Shrutik-KaPatel/SpinDoctor/Docs/Images/1I.png

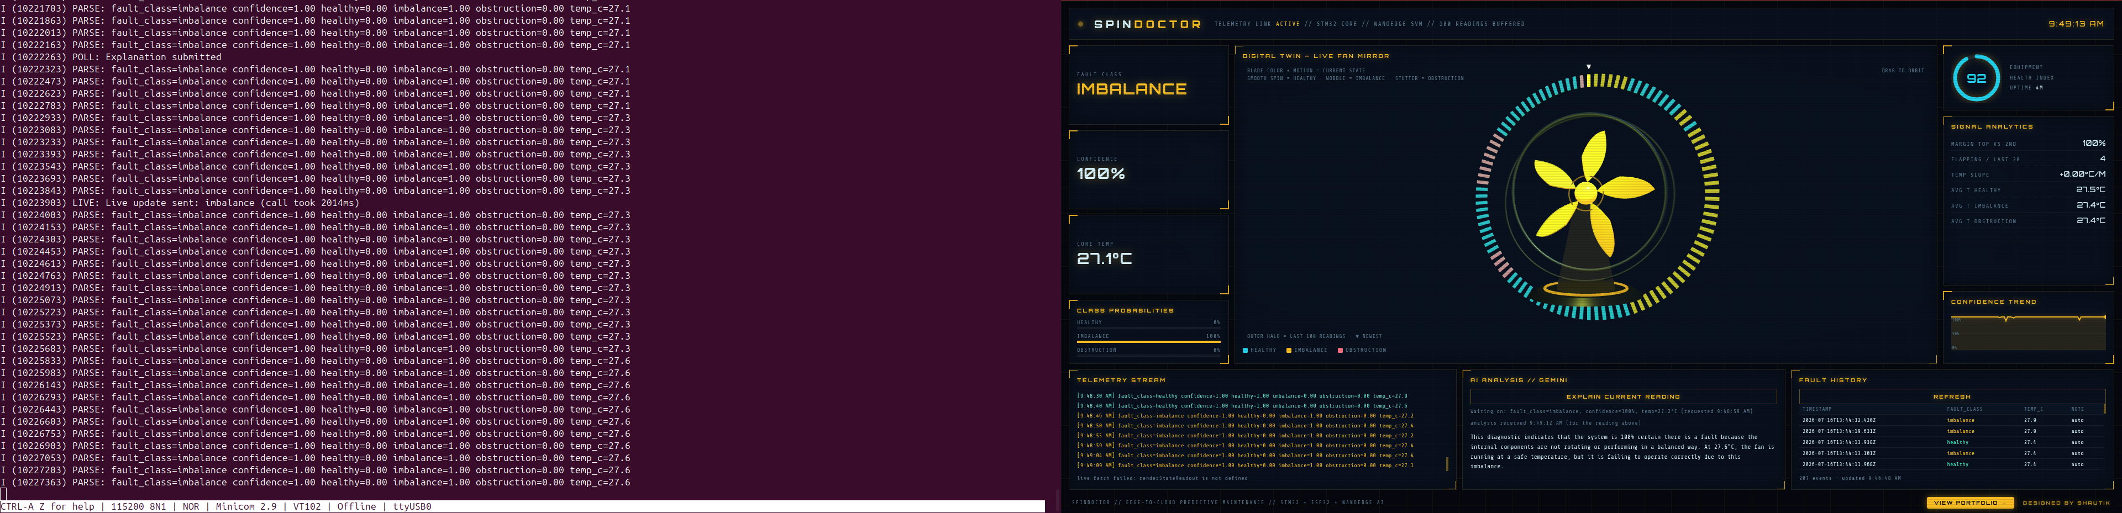
Docs/Images/1I.png
