Shrutik-KaPatel/SpinDoctor/Docs/Images/1O.png

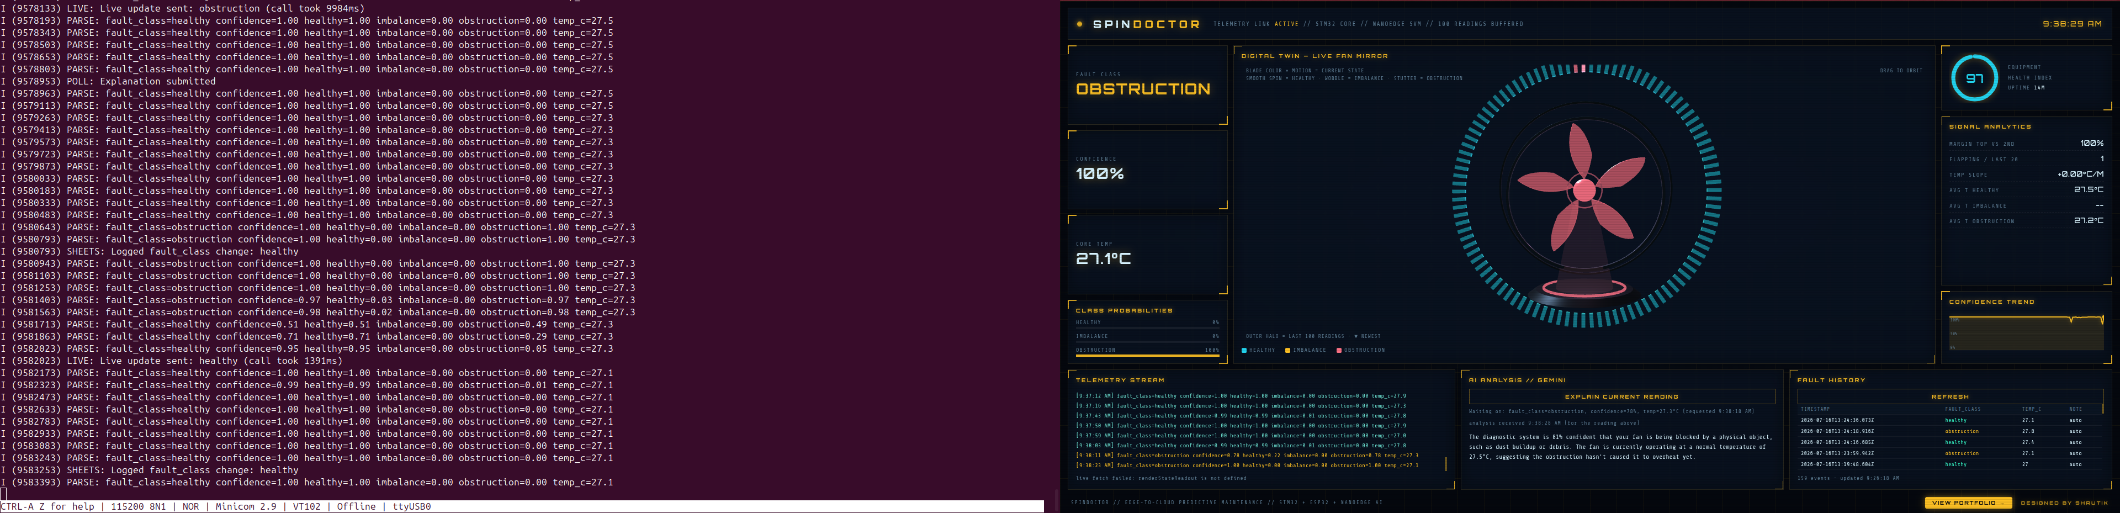
Docs/Images/1O.png
