Shrutik-KaPatel/SpinDoctor/firmware/stm32/SpinDoctor_STM32/SpinDoctor_STM32.ioc

Mcu.UserName=STM32F407VGTx
PA2.Signal=USART2_TX
PA3.Signal=USART2_RX
PA5.Signal=SPI1_SCK
PA6.Signal=SPI1_MISO
PA7.Signal=SPI1_MOSI
PB10.Signal=USART3_TX
PB11.Signal=USART3_RX
PB6.GPIO_Label=DHT11_DATA
PB6.Signal=GPIO_Output
PE0.Signal=GPXTI0
PE3.GPIO_Label=LIS3DSH_CS
PE3.Signal=GPIO_Output
