Shrutik-KaPatel/SpinDoctor/firmware/stm32/SpinDoctor_STM32/Core/Src/main.c

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
/* Includes ------------------------------------------------------------------*/
#include "main.h"
#include "cmsis_os.h"

/* USER CODE BEGIN Includes */
#include <stdio.h>
#include <LIS3DSHTR.h>
#include "DHT11.h"
#include "NanoEdgeAI.h"

/* USER CODE END Includes */

ADC_HandleTypeDef hadc1;
DMA_HandleTypeDef hdma_adc1;

IWDG_HandleTypeDef hiwdg;

SPI_HandleTypeDef hspi1;
DMA_HandleTypeDef hdma_spi1_rx;
DMA_HandleTypeDef hdma_spi1_tx;

UART_HandleTypeDef huart2;
UART_HandleTypeDef huart3;
DMA_HandleTypeDef hdma_usart2_tx;

osThreadId AccelTaskHandle;
osThreadId DHT11TaskHandle;
osThreadId WatchdogTaskHandle;
osThreadId CaptureTaskHandle;
osThreadId InferenceTaskHandle;
osMutexId diagnosticsMutexHandle;
osMutexId printfMutexHandle;
osSemaphoreId uartTxSemaphoreHandle;
osSemaphoreId captureDataReadyHandle;
osSemaphoreId captureRxByteReadyHandle;
/* USER CODE BEGIN PV */
LIS3_HandleTypeDef hlis;
LIS3_DataTypeDef   data;

/* Single-element circular DMA buffer for ADC1 temperature reads.
 * volatile because DMA writes it from hardware, not CPU code.
 * uint16_t because ADC is 12-bit (max 4095), needs 16-bit storage. */
volatile uint16_t adc_temp_raw;

/* DWT cycle counter, used for precise microsecond delays needed by
 * the 1-Wire protocol. Cortex-M4 core feature, not a normal STM32
 * peripheral, has nothing to do with HAL and needs no CubeMX setup. */
#define DWT_CYCCNT  (*(volatile uint32_t*)0xE0001004)
#define DWT_CTRL    (*(volatile uint32_t*)0xE0001000)
#define DEM_CR      (*(volatile uint32_t*)0xE000EDFC)

DiagnosticsData diagnostics = {0};

#define CAPTURE_BUF_SIZE 64   /* samples per axis per buffer, matches
                                 * original FFT window sizing rationale:
                                 * enough periods per buffer at expected
                                 * fan RPM, arbitrary otherwise for raw
                                 * capture, NanoEdge does its own windowing */
#define CAPTURE_WINDOW_COUNT 350   /* ~56s at 400Hz / 64-sample windows,
 	 	 	 	 	 	 	 	 	 * bumped from 156 to give NanoEdge more
 	 	 	 	 	 	 	 	 	 * examples of speed1_healthy specifically */

int16_t capture_buf_x[2][CAPTURE_BUF_SIZE];
int16_t capture_buf_y[2][CAPTURE_BUF_SIZE];
int16_t capture_buf_z[2][CAPTURE_BUF_SIZE];
volatile uint8_t capture_fill_idx = 0;
volatile uint16_t capture_sample_count = 0;
volatile uint8_t capture_ready_idx = 0;

/* Set true only while an active capture window is streaming; AccelTask
 * checks this before bothering to fill the capture buffers or release
 * the semaphore, so there's zero extra work happening between capture
 * sessions. */
volatile uint8_t capture_active = 0;


uint8_t uart_rx_byte;
/* USER CODE END PV */

void SystemClock_Config(void);
static void MX_GPIO_Init(void);
static void MX_DMA_Init(void);
static void MX_SPI1_Init(void);
static void MX_USART2_UART_Init(void);
static void MX_ADC1_Init(void);
static void MX_IWDG_Init(void);
static void MX_USART3_UART_Init(void);
void StartAccelTask(void const * argument);
void StartDHT11Task(void const * argument);
void StartWatchdogTask(void const * argument);
void StartCaptureTask(void const * argument);
void StartInferenceTask(void const * argument);

/**
  * @brief  The application entry point.
  * @retval int
  */
int main(void)
{

  /* MCU Configuration--------------------------------------------------------*/

  /* Reset of all peripherals, Initializes the Flash interface and the Systick. */
  HAL_Init();

  /* Configure the system clock */
  SystemClock_Config();

  /* Initialize all configured peripherals */
  MX_GPIO_Init();
  MX_DMA_Init();
  MX_SPI1_Init();
  MX_USART2_UART_Init();
  MX_ADC1_Init();
  MX_IWDG_Init();
  MX_USART3_UART_Init();
  /* USER CODE BEGIN 2 */
  hlis.hspi    = &hspi1;
    hlis.cs_port = GPIOE;
    hlis.cs_pin  = GPIO_PIN_3;

    LIS3_Init(&hlis);                                                /* sets ODR=400Hz, all axes enabled */
    LIS3_WriteReg(&hlis, LIS3_CTRL_REG3, LIS3_CTRL_REG3_DRDY_INT1);   /* NEW: routes DRDY to INT1/PE0, without
                                                                        this the chip never pulses PE0 and
                                                                        no EXTI interrupt ever fires */
    /* Enable the DWT cycle counter. Required by delay_us() and DHT11's
         * bit-timing. Missing since Session 8 cleanup, silently hangs
         * DHT11Task forever without it, no crash, just permanently stuck. */
        DEM_CR |= (1 << 24);
        DWT_CYCCNT = 0;
        DWT_CTRL |= 1;

    /* Start ADC1 in DMA circular mode. From this point the DMA keeps
     * adc_temp_raw updated automatically on every completed conversion,
     * no further software trigger needed. HAL_ADC_Start_DMA takes the
     * buffer pointer and length (1 element here, one channel only). */
    HAL_ADC_Start_DMA(&hadc1, (uint32_t*)&adc_temp_raw, 1);

    /* Start interrupt-driven UART receive for the capture menu. Blocking/
     * polling-mode HAL_UART_Receive doesn't coexist safely with DMA-based
     * TX already active on this same UART (used by printf), it can return
     * immediately with a busy/error state instead of genuinely blocking.
     * Interrupt-driven RX avoids that conflict entirely. */
    HAL_UART_Receive_IT(&huart2, &uart_rx_byte, 1);

    /* Initialize the NanoEdge AI classification model, loading the
     * pretrained SVM library generated from today's benchmark. Must be
     * called once before any neai_classification() calls. */
    enum neai_state neai_init_state = neai_classification_init();
    if (neai_init_state != NEAI_OK)
    {
        /* If the model fails to load, halt here rather than silently
         * running with an uninitialized classifier. */
        Error_Handler();
    }
  /* USER CODE END 2 */

  /* Create the mutex(es) */
  /* definition and creation of diagnosticsMutex */
  osMutexDef(diagnosticsMutex);
  diagnosticsMutexHandle = osMutexCreate(osMutex(diagnosticsMutex));

  /* definition and creation of printfMutex */
  osMutexDef(printfMutex);
  printfMutexHandle = osMutexCreate(osMutex(printfMutex));

  /* USER CODE BEGIN RTOS_MUTEX */
  /* add mutexes, ... */
  /* USER CODE END RTOS_MUTEX */

  /* Create the semaphores(s) */
  /* definition and creation of uartTxSemaphore */
  osSemaphoreDef(uartTxSemaphore);
  uartTxSemaphoreHandle = osSemaphoreCreate(osSemaphore(uartTxSemaphore), 1);

  /* definition and creation of captureDataReady */
  osSemaphoreDef(captureDataReady);
  captureDataReadyHandle = osSemaphoreCreate(osSemaphore(captureDataReady), 1);

  /* definition and creation of captureRxByteReady */
  osSemaphoreDef(captureRxByteReady);
  captureRxByteReadyHandle = osSemaphoreCreate(osSemaphore(captureRxByteReady), 1);

  /* USER CODE BEGIN RTOS_SEMAPHORES */
  /* captureDataReadyHandle is created with 1 token by default in
   * CMSIS_V1 regardless of the "Available" GUI setting, drain it here
   * so CaptureTask correctly blocks until AccelTask actually signals a
   * completed window, rather than running once immediately on boot. */
  osSemaphoreWait(captureDataReadyHandle, 0);

  osSemaphoreWait(captureRxByteReadyHandle, 0);
  /* add semaphores, ... */
  /* USER CODE END RTOS_SEMAPHORES */

  /* USER CODE BEGIN RTOS_TIMERS */
  /* start timers, add new ones, ... */
  /* USER CODE END RTOS_TIMERS */

  /* USER CODE BEGIN RTOS_QUEUES */
  /* add queues, ... */
  /* USER CODE END RTOS_QUEUES */

  /* Create the thread(s) */
  /* definition and creation of AccelTask */
  osThreadDef(AccelTask, StartAccelTask, osPriorityNormal, 0, 512);
  AccelTaskHandle = osThreadCreate(osThread(AccelTask), NULL);

  /* definition and creation of DHT11Task */
  osThreadDef(DHT11Task, StartDHT11Task, osPriorityLow, 0, 256);
  DHT11TaskHandle = osThreadCreate(osThread(DHT11Task), NULL);

  /* definition and creation of WatchdogTask */
  osThreadDef(WatchdogTask, StartWatchdogTask, osPriorityLow, 0, 512);
  WatchdogTaskHandle = osThreadCreate(osThread(WatchdogTask), NULL);

  /* definition and creation of CaptureTask */
  osThreadDef(CaptureTask, StartCaptureTask, osPriorityBelowNormal, 0, 512);
  CaptureTaskHandle = osThreadCreate(osThread(CaptureTask), NULL);

  /* definition and creation of InferenceTask */
  osThreadDef(InferenceTask, StartInferenceTask, osPriorityBelowNormal, 0, 1024);
  InferenceTaskHandle = osThreadCreate(osThread(InferenceTask), NULL);

  /* USER CODE BEGIN RTOS_THREADS */
  if (AccelTaskHandle == NULL)     { HAL_UART_Transmit(&huart2, (uint8_t*)"AccelTask FAILED\r\n", 18, HAL_MAX_DELAY); }
  if (DHT11TaskHandle == NULL)     { HAL_UART_Transmit(&huart2, (uint8_t*)"DHT11Task FAILED\r\n", 18, HAL_MAX_DELAY); }
  if (WatchdogTaskHandle == NULL)  { HAL_UART_Transmit(&huart2, (uint8_t*)"WatchdogTask FAILED\r\n", 21, HAL_MAX_DELAY); }
  if (CaptureTaskHandle == NULL)   { HAL_UART_Transmit(&huart2, (uint8_t*)"CaptureTask FAILED\r\n", 20, HAL_MAX_DELAY); }
  if (InferenceTaskHandle == NULL) { HAL_UART_Transmit(&huart2, (uint8_t*)"InferenceTask FAILED\r\n", 22, HAL_MAX_DELAY); }

  /* add threads, ... */
  /* USER CODE END RTOS_THREADS */

  /* Start scheduler */
  osKernelStart();

  /* We should never get here as control is now taken by the scheduler */

  /* Infinite loop */
  /* USER CODE BEGIN WHILE */
  while (1)
  {

    /* USER CODE END WHILE */

    /* USER CODE BEGIN 3 */

  }
  /* USER CODE END 3 */
}

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
/* USER CODE BEGIN 4 */
int _write(int file, char *ptr, int len)
{
    osSemaphoreWait(uartTxSemaphoreHandle, osWaitForever);

    HAL_StatusTypeDef status = HAL_UART_Transmit_DMA(&huart2, (uint8_t*)ptr, len);
    if (status != HAL_OK)
    {
        /* DMA transfer never actually started, don't wait for a callback
         * that will never fire. Release immediately and bail. */
        osSemaphoreRelease(uartTxSemaphoreHandle);
        return 0;
    }

    /* Bounded wait instead of osWaitForever, so a stuck transfer surfaces
     * as a dropped line instead of a silent whole-system freeze. */
    osStatus wait_result = osSemaphoreWait(uartTxSemaphoreHandle, 200);
    if (wait_result != osOK)
    {
        /* Transfer never completed within 200ms, something is stuck.
         * Don't propagate the hang further, release and move on. */
        osSemaphoreRelease(uartTxSemaphoreHandle);
        return 0;
    }

    osSemaphoreRelease(uartTxSemaphoreHandle);
    return len;
}
/* FreeRTOS calls this automatically if stack overflow checking
 * (Method 2) detects a task has overrun its allocated stack. Uses
 * direct blocking HAL_UART_Transmit, not printf: the offending
 * task's stack may already be corrupted, and printf's internal
 * formatting pushes more onto that same stack, risking further
 * corruption before the message gets out. */
void vApplicationStackOverflowHook(TaskHandle_t xTask, char *pcTaskName)
{
    char msg[64];
    int len = 0;
    const char *prefix = "!!! STACK OVERFLOW in task: ";
    while (prefix[len]) { msg[len] = prefix[len]; len++; }
    int i = 0;
    while (pcTaskName[i] && len < 60) { msg[len++] = pcTaskName[i++]; }
    msg[len++] = '\r';
    msg[len++] = '\n';

    HAL_UART_Transmit(&huart2, (uint8_t*)msg, len, HAL_MAX_DELAY);

    while(1) { }
}
/* HAL calls this automatically once a UART DMA transmit completes.
 * Releasing the semaphore here, not inside _write() itself, is what
 * makes this safe across tasks, the next printf can't start a new
 * transfer until the hardware confirms the previous one is done. */
void HAL_UART_TxCpltCallback(UART_HandleTypeDef *huart)
{
    if (huart->Instance == USART2)
    {
        osSemaphoreRelease(uartTxSemaphoreHandle);
    }
}

/* Fires on every DRDY rising edge from the LIS3DSH, i.e. every new
 * sample at 400Hz. Kicks off the DMA burst read; the rest of the
 * sequence (Tx complete -> Rx complete) continues in the two
 * callbacks below, this function does not wait for any of it. */
void HAL_GPIO_EXTI_Callback(uint16_t GPIO_Pin)
{
    if (GPIO_Pin == GPIO_PIN_0)
    {
        LIS3_StartBurstRead_DMA(&hlis, &data);
    }
}

/* HAL calls this automatically once the 1-byte address transmit (started
 * inside LIS3_StartBurstRead_DMA) completes. Library handler starts the
 * matching 6-byte receive. */
void HAL_SPI_TxCpltCallback(SPI_HandleTypeDef *hspi)
{
    LIS3_DMA_TxCpltHandler();
}

/* HAL calls this once the 6 data bytes have landed. Library handler
 * raises CS, reconstructs X/Y/Z, and sets LIS3_DataReady for the main
 * loop to pick up. */
void HAL_SPI_RxCpltCallback(SPI_HandleTypeDef *hspi)
{
    LIS3_DMA_RxCpltHandler();
}

/* Busy-wait for a precise number of microseconds, using the DWT cycle
 * counter. SystemCoreClock is 168000000 (168MHz) in this project, so
 * cycles-per-microsecond = 168. Unsigned subtraction handles the
 * counter wrapping the same way the timer capture did earlier. */
void delay_us(uint32_t us)
{
    uint32_t start = DWT_CYCCNT;
    uint32_t cycles = us * (SystemCoreClock / 1000000);
    while ((DWT_CYCCNT - start) < cycles) { }
}

/* HAL calls this automatically once one byte has been received via
 * HAL_UART_Receive_IT. Releases the semaphore CaptureTask blocks on,
 * then immediately re-arms itself to listen for the next byte. */
void HAL_UART_RxCpltCallback(UART_HandleTypeDef *huart)
{
    if (huart->Instance == USART2)
    {
        osSemaphoreRelease(captureRxByteReadyHandle);
        HAL_UART_Receive_IT(&huart2, &uart_rx_byte, 1);
    }
}

/* USER CODE END 4 */

/* USER CODE BEGIN Header_StartAccelTask */
/**
  * @brief  Function implementing the AccelTask thread.
  * @param  argument: Not used
  * @retval None
  */
/* USER CODE END Header_StartAccelTask */
void StartAccelTask(void const * argument)
{
  /* USER CODE BEGIN 5 */
	for(;;)
		  {
		      if (LIS3_DataReady)
		      {
		          LIS3_DataReady = 0;

		          /* Buffer fill and semaphore release now happen on EVERY
		           * sample unconditionally, not just during a training
		           * capture. InferenceTask needs a continuous stream of
		           * windows during normal operation to do live classification;
		           * CaptureTask needs the same stream during a capture
		           * session. capture_active now only controls whether the
		           * throttled diagnostic X:Y:Z line also prints, it no longer
		           * gates whether data flows into the shared buffer at all. */
		          capture_buf_x[capture_fill_idx][capture_sample_count] = data.x;
		          capture_buf_y[capture_fill_idx][capture_sample_count] = data.y;
		          capture_buf_z[capture_fill_idx][capture_sample_count] = data.z;
		          capture_sample_count++;

		          if (capture_sample_count >= CAPTURE_BUF_SIZE)
		          {
		              capture_ready_idx = capture_fill_idx;
		              capture_fill_idx = 1 - capture_fill_idx;
		              capture_sample_count = 0;
		              osSemaphoreRelease(captureDataReadyHandle);
		          }

		          if (!capture_active)
		          {
		              /* Normal throttled diagnostic print, only when NOT
		               * capturing, keeps the UART stream clean and parseable
		               * during an active capture window. */
		              static uint16_t print_counter = 0;
		              if (++print_counter >= 40)
		              {
		                  print_counter = 0;

		                  osMutexWait(diagnosticsMutexHandle, osWaitForever);
		                  diagnostics.accel_x = data.x;
		                  diagnostics.accel_y = data.y;
		                  diagnostics.accel_z = data.z;
		                  osMutexRelease(diagnosticsMutexHandle);

		                  osMutexWait(printfMutexHandle, osWaitForever);
		                  printf("X:%d Y:%d Z:%d\r\n", data.x, data.y, data.z);
		                  osMutexRelease(printfMutexHandle);
		              }
		          }
		      }
		    osDelay(1);
		  }
  /* USER CODE END 5 */
}

/* USER CODE BEGIN Header_StartDHT11Task */
/**
* @brief Function implementing the DHT11Task thread.
* @param argument: Not used
* @retval None
*/
/* USER CODE END Header_StartDHT11Task */
void StartDHT11Task(void const * argument)
{
  /* USER CODE BEGIN StartDHT11Task */
	 osDelay(3000);   /* let power rails and the sensor itself settle before
	                       the very first 1-Wire transaction; avoids racing
	                       boot-time GPIO/timing edge cases */
  /* Infinite loop */
  for(;;)
  {
	  if (!capture_active)
	      {
	          DHT11_Data dht;
	          if (DHT11_Read(&dht))
	          {
	              osMutexWait(diagnosticsMutexHandle, osWaitForever);
	              diagnostics.humidity_int = dht.humidity_int;
	              diagnostics.humidity_dec = dht.humidity_dec;
	              diagnostics.temp_int     = dht.temp_int;
	              diagnostics.temp_dec     = dht.temp_dec;
	              osMutexRelease(diagnosticsMutexHandle);

	              osMutexWait(printfMutexHandle, osWaitForever);
	              printf("DHT11: %d.%d%% RH, %d.%dC\r\n",
	                     dht.humidity_int, dht.humidity_dec,
	                     dht.temp_int, dht.temp_dec);
	              osMutexRelease(printfMutexHandle);
	          }
	          else
	          {
	              osMutexWait(printfMutexHandle, osWaitForever);
	              printf("DHT11: read failed\r\n");
	              osMutexRelease(printfMutexHandle);
	          }
	      }
	      osDelay(3000);
  }
  /* USER CODE END StartDHT11Task */
}

/* USER CODE BEGIN Header_StartWatchdogTask */
/**
* @brief Function implementing the WatchdogTask thread.
* @param argument: Not used
* @retval None
*/
/* USER CODE END Header_StartWatchdogTask */
void StartWatchdogTask(void const * argument)
{
  /* USER CODE BEGIN StartWatchdogTask */

	  /* Reset-cause check, printed once at boot so we can tell whether the
	   * last reset was a normal power-on, a manual reset, or the IWDG
	   * catching a genuine freeze elsewhere in the system. */
	    osMutexWait(printfMutexHandle, osWaitForever);
	    if (__HAL_RCC_GET_FLAG(RCC_FLAG_IWDGRST))
	        printf("RESET: IWDG\r\n");
	    else if (__HAL_RCC_GET_FLAG(RCC_FLAG_LPWRRST))
	        printf("RESET: LOW POWER / BROWNOUT\r\n");
	    else if (__HAL_RCC_GET_FLAG(RCC_FLAG_PORRST))
	        printf("RESET: POWER-ON\r\n");
	    else if (__HAL_RCC_GET_FLAG(RCC_FLAG_PINRST))
	        printf("RESET: PIN/NRST\r\n");
	    else
	        printf("RESET: OTHER/UNKNOWN\r\n");
	    osMutexRelease(printfMutexHandle);
	    __HAL_RCC_CLEAR_RESET_FLAGS();

	    /* Infinite loop */
	    for(;;)
	    {
	        /* Refresh every 500ms, comfortably under the 2-second IWDG
	         * window. This task only ever runs if the scheduler is still
	         * actually switching between tasks, if any task hangs hard
	         * enough to starve the scheduler entirely, this refresh stops
	         * happening and IWDG forces a full chip reset within 2 seconds. */
	        HAL_IWDG_Refresh(&hiwdg);
	        osDelay(500);
	    }

  /* USER CODE END StartWatchdogTask */
}

/* USER CODE BEGIN Header_StartCaptureTask */
/**
* @brief Function implementing the CaptureTask thread.
* @param argument: Not used
* @retval None
*/
/* USER CODE END Header_StartCaptureTask */
void StartCaptureTask(void const * argument)
{
  /* USER CODE BEGIN StartCaptureTask */
	 uint8_t rx_byte;
	  char speed_char = 0;
	  char class_char = 0;

	  for(;;)
	  {
	      /* --- Menu: prompt for speed + class --- */
		  osMutexWait(printfMutexHandle, osWaitForever);
		  printf("\r\n=== SpinDoctor Capture Menu ===\r\n"
		         "Speed:  1) Low  2) Medium  3) High\r\n"
		         "Class:  H) Healthy  I) Imbalance  O) Obstruction\r\n"
		         "Enter as two chars, e.g. \"1H\": ");
		  osMutexRelease(printfMutexHandle);

	      /* Blocking receive, one byte at a time. This task has nothing
	       * else to do while waiting for menu input, so a simple blocking
	       * HAL_UART_Receive call here is fine, no interrupt/queue needed. */
		  osSemaphoreWait(captureRxByteReadyHandle, osWaitForever);
		  rx_byte = uart_rx_byte;
	      speed_char = (char)rx_byte;
	      osSemaphoreWait(captureRxByteReadyHandle, osWaitForever);
	      rx_byte = uart_rx_byte;
	      class_char = (char)rx_byte;

	      uint8_t valid_speed = (speed_char == '1' || speed_char == '2' || speed_char == '3');
	      uint8_t valid_class = (class_char == 'H' || class_char == 'I' || class_char == 'O' ||
	                              class_char == 'h' || class_char == 'i' || class_char == 'o');

	      if (!valid_speed || !valid_class)
	      {
	          osMutexWait(printfMutexHandle, osWaitForever);
	          printf("\r\nInvalid input, try again.\r\n");
	          osMutexRelease(printfMutexHandle);
	          continue;
	      }

	      const char *class_name;
	      switch (class_char)
	      {
	          case 'H': case 'h': class_name = "healthy";    break;
	          case 'I': case 'i': class_name = "imbalance";  break;
	          default:            class_name = "obstruction"; break;
	      }
	      char label[32];
	      sprintf(label, "speed%c_%s", speed_char, class_name);

	      osMutexWait(printfMutexHandle, osWaitForever);
	      printf("\r\nSelected: Speed %c, %s. Set up the fan now.\r\n"
	             "Send 'S' when stable and ready to capture, 'X' to cancel and return to menu.\r\n",
	             speed_char, class_name);
	      osMutexRelease(printfMutexHandle);

	      char cmd;
	      do
	      {
	    	  osSemaphoreWait(captureRxByteReadyHandle, osWaitForever);
	    	     cmd = (char)uart_rx_byte;
	      } while (cmd != 'S' && cmd != 's' && cmd != 'X' && cmd != 'x');

	      if (cmd == 'X' || cmd == 'x')
	      {
	          osMutexWait(printfMutexHandle, osWaitForever);
	          printf("\r\nCancelled, returning to menu.\r\n");
	          osMutexRelease(printfMutexHandle);
	          continue;
	      }

	      /* --- Active capture --- */
	      osMutexWait(printfMutexHandle, osWaitForever);
	      printf("\r\n=== CAPTURE START: %s ===\r\n", label);
	      osMutexRelease(printfMutexHandle);

	      osSemaphoreWait(captureDataReadyHandle, 0);
	      capture_fill_idx = 0;
	      capture_sample_count = 0;
	      capture_active = 1;

	      for (int w = 0; w < CAPTURE_WINDOW_COUNT; w++)
	      {
	          osSemaphoreWait(captureDataReadyHandle, osWaitForever);
	          uint8_t idx = capture_ready_idx;

	          static char row_buf[4][6000];
	                   static uint8_t row_buf_idx = 0;

	                   int pos = 0;
	                   for (int i = 0; i < CAPTURE_BUF_SIZE; i++)
	                   {
	                       pos += sprintf(row_buf[row_buf_idx] + pos, "%d,%d,%d",
	                                      capture_buf_x[idx][i],
	                                      capture_buf_y[idx][i],
	                                      capture_buf_z[idx][i]);
	                       if (i < CAPTURE_BUF_SIZE - 1) row_buf[row_buf_idx][pos++] = ',';
	                   }
	                   row_buf[row_buf_idx][pos++] = '\r';
	                   row_buf[row_buf_idx][pos++] = '\n';
	                   row_buf[row_buf_idx][pos] = '\0';

	                   uint32_t t_start = DWT_CYCCNT;

	                             osMutexWait(printfMutexHandle, osWaitForever);
	                             printf("%s", row_buf[row_buf_idx]);
	                             osMutexRelease(printfMutexHandle);

	                             uint32_t t_elapsed_us = (DWT_CYCCNT - t_start) / (SystemCoreClock / 1000000);

	                             static uint16_t dbg_counter = 0;
	                             if (++dbg_counter >= 20)
	                             {
	                                 dbg_counter = 0;
	                                 osMutexWait(printfMutexHandle, osWaitForever);
	                                 printf("[row took %luus]\r\n", (unsigned long)t_elapsed_us);
	                                 osMutexRelease(printfMutexHandle);
	                             }

	                             row_buf_idx = (row_buf_idx + 1) % 4;
	      }

	      capture_active = 0;

	      osMutexWait(printfMutexHandle, osWaitForever);
	      printf("=== CAPTURE END: %s ===\r\n", label);
	      osMutexRelease(printfMutexHandle);
	  }
  /* USER CODE END StartCaptureTask */
}

/* USER CODE BEGIN Header_StartInferenceTask */
/**
* @brief Function implementing the InferenceTask thread.
* @param argument: Not used
* @retval None
*/
/* USER CODE END Header_StartInferenceTask */
void StartInferenceTask(void const * argument)
{
  /* USER CODE BEGIN StartInferenceTask */
	float input_signal[NEAI_INPUT_SIGNAL_LENGTH * NEAI_INPUT_AXIS_NUMBER];
		  float probabilities[NEAI_NUMBER_OF_CLASSES];
		  int id_class;
		  enum neai_state state;

		  for(;;)
		  {
		      osSemaphoreWait(captureDataReadyHandle, osWaitForever);

		      /* Only run inference when NOT in an active training capture
		       * session. CaptureTask and InferenceTask share the same
		       * capture-buffer/semaphore pair; during a capture, CaptureTask
		       * owns that data exclusively (streaming it for NanoEdge Studio
		       * training), so InferenceTask must skip processing to avoid
		       * silently splitting windows between the two consumers. */
		      if (capture_active)
		      {
		          continue;
		      }

		      uint8_t idx = capture_ready_idx;

		      for (int i = 0; i < CAPTURE_BUF_SIZE; i++)
		      {
		          input_signal[i * 3 + 0] = (float)capture_buf_x[idx][i];
		          input_signal[i * 3 + 1] = (float)capture_buf_y[idx][i];
		          input_signal[i * 3 + 2] = (float)capture_buf_z[idx][i];
		      }

		      state = neai_classification(input_signal, probabilities, &id_class);

		      if (state == NEAI_OK)
		      {
		          const char* class_names[] = {"obstruction", "imbalance", "healthy"};

		          osMutexWait(printfMutexHandle, osWaitForever);
		          printf("Fault class: %s (%.1f%%)\r\n",
		                 class_names[id_class],
		                 probabilities[id_class] * 100.0f);
		          osMutexRelease(printfMutexHandle);

		          /* Grab the latest DHT11 temperature reading under its mutex,
		           * combine integer/decimal parts into a single float. */
		          osMutexWait(diagnosticsMutexHandle, osWaitForever);
		          float temp_c = diagnostics.temp_int + (diagnostics.temp_dec / 10.0f);
		          osMutexRelease(diagnosticsMutexHandle);

		          /* Build the JSON line for the ESP32 gateway and send over
		           * USART3. Class index mapping matches class_names[] above:
		           * 0=obstruction, 1=imbalance, 2=healthy. */
		          char uart3_msg[160];
		          int len = sprintf(uart3_msg,
		              "{\"fault_class\":\"%s\",\"confidence\":%.2f,"
		              "\"healthy\":%.2f,\"imbalance\":%.2f,\"obstruction\":%.2f,"
		              "\"temp_c\":%.1f}\n",
		              class_names[id_class], probabilities[id_class],
		              probabilities[2], probabilities[1], probabilities[0],
		              temp_c);
		          HAL_UART_Transmit(&huart3, (uint8_t*)uart3_msg, len, HAL_MAX_DELAY);
		      }
		  }
  /* USER CODE END StartInferenceTask */
}

/**
  * @brief  Period elapsed callback in non blocking mode
  * @note   This function is called  when TIM6 interrupt took place, inside
  * HAL_TIM_IRQHandler(). It makes a direct call to HAL_IncTick() to increment
  * a global variable "uwTick" used as application time base.
  * @param  htim : TIM handle
  * @retval None
  */
void HAL_TIM_PeriodElapsedCallback(TIM_HandleTypeDef *htim)
{
  if (htim->Instance == TIM6)
  {
    HAL_IncTick();
  }
}

/**
  * @brief  This function is executed in case of error occurrence.
  * @retval None
  */
void Error_Handler(void)
{
  /* USER CODE BEGIN Error_Handler_Debug */
  /* User can add his own implementation to report the HAL error return state */
  __disable_irq();
  while (1)
  {
  }
  /* USER CODE END Error_Handler_Debug */
}
#ifdef USE_FULL_ASSERT
/**
  * @brief  Reports the name of the source file and the source line number
  *         where the assert_param error has occurred.
  * @param  file: pointer to the source file name
  * @param  line: assert_param error line source number
  * @retval None
  */
void assert_failed(uint8_t *file, uint32_t line)
{
  /* USER CODE BEGIN 6 */
  /* User can add his own implementation to report the file name and line number,
     ex: printf("Wrong parameters value: file %s on line %d\r\n", file, line) */
  /* USER CODE END 6 */
}
#endif /* USE_FULL_ASSERT */
