Shrutik-KaPatel/SpinDoctor/(commit log)

2026-06-29 feat(stm32): DMA burst read of LIS3DSH triggered by DRDY interrupt at 400Hz
2026-06-29 docs: log accelerometer DMA/DRDY milestone
2026-06-30 feat(stm32): add SpinDoctor_STM32 CubeMX project skeleton
2026-06-30 feat(stm32): implement DHT11 temperature/humidity sensing on PB6, replacing internal die temp sensor
2026-06-30 feat(stm32): retrofit FreeRTOS, split accel and DHT11 into separate tasks by priority
2026-06-30 Revise PROGRESS.md with session updates
    Updated progress log to reflect new sessions and changes in sensor integration and FreeRTOS implementation.
2026-06-30 feat(stm32): add IWDG watchdog with dedicated low-priority refresh task
2026-06-30 feat(stm32): add mutex-protected diagnostics struct shared between AccelTask and DHT11Task
2026-06-30 feat(stm32): UART TX via DMA with semaphore serialization, remove pre-kernel debug prints
2026-06-30 docs: log UART DMA TX and pre-kernel semaphore bug
2026-06-30 feat(stm32): add ping-pong double buffering to LIS3DSH DMA burst read
2026-06-30 docs: log ping-pong double buffering on accel DMA
2026-07-01 fix(stm32): restore DWT cycle counter enable, missing since Session 8
    [main.c]
2026-07-01 fix(stm32): serialize printf across tasks with printfMutex, prevents newlib reentrancy corruption
    [main.c]
2026-07-01 chore: sync .ioc after printfMutex generation
2026-07-01 feat(stm32): enable stack overflow detection (Method 2) with safe UART-only hook
2026-07-02 fix(stm32): resolve UART DMA race corrupting capture rows, 3-buffer ping-pong + smaller windows
    [main.c]
2026-07-07 fix(stm32): 4-buffer ping-pong + 460800 baud for capture streaming
    [SpinDoctor_STM32.ioc, main.c]
2026-07-07 data: add cleaned CSV captures and cleaning script, remove stray raw/.gitkeep
    [speed1_healthy_clean.csv, speed1_imbalance_clean.csv, speed1_obstruction_clean.csv, speed2_healthy_clean.csv, speed2_imbalance_clean.csv, speed2_obstruction_clean.csv, speed3_healthy_clean.csv, speed3_imbalance_clean.csv]
2026-07-13 feat(stm32): integrate NanoEdge AI SVM classifier into InferenceTask
    - deploy trained SVM library (100% balanced accuracy on speed2/3 benchmark)
    - fix semaphore release bug: was only released during training captures,
    now releases during normal operation for continuous inference
    - add .gitignore for NanoEdge Studio zip artifacts and host emulator tooling
    [SpinDoctor_STM32.ioc, main.c]
2026-07-13 fix(stm32): resolve stack overflows in AccelTask/DHT11Task/WatchdogTask, enable FPU, fix printf DMA race
    - _write() now blocks until DMA TxCplt confirms completion, fixing menu/
    diagnostic print corruption caused by concurrent buffer reuse
    - bump AccelTask 128->256, DHT11Task 128->256, WatchdogTask 128->512 words,
    resolving three separate silent stack overflows found via J-Link/ST-LINK
    debugger call-stack inspection (vApplicationStackOverflowHook)
    - enable configENABLE_FPU, required for safe FPU register context switching
    now that InferenceTask does floating-point SVM inference
    - bump CAPTURE_WINDOW_COUNT 156->350 for richer per-class training data
    data: full recapture of all 9 spee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
    [speed1_healthy_clean.csv, speed1_imbalance_clean.csv, speed1_obstruction_clean.csv, speed2_healthy_clean.csv, speed2_imbalance_clean.csv, speed2_obstruction_clean.csv, speed3_healthy_clean.csv, speed3_imbalance_clean.csv]
2026-07-13 Refactor PROGRESS.md with session updates and fixes
    Updated session headings and detailed progress on various tasks, including fixes for bugs related to UART DMA, printf corruption, and stack overflows. Improved repo organization and clarified findings from model testing.
2026-07-14 feat(stm32): deploy retrained CNN model, fix class name display
    - swap SVM library for new CNN model (library #57), retrained on the
    350-window recapture across all 9 speed/class combinations
    - CNN resolves the speed1 healthy misclassification seen with the
    original SVM model; verified live at all 3 speeds for healthy and
    imbalance classes (obstruction verification pending)
    - fix Fault class printf: neai_get_class_name() was returning a raw
    index character instead of a name string for this library build,
    replaced with a hardcoded class_names[] lookup matching the verified
    order from metadata.json (obstruction, imbalance, healthy)
    - gitignore local SVM backup folder, not needed in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
    [main.c]
2026-07-14 Add ESP32 gateway: custom partition table, NVS-based WiFi credentials, WiFi station bring-up with retry logic
    [partitions.csv]
2026-07-14 Add STM32-ESP32 UART link: USART3 JSON telemetry from InferenceTask to ESP32 UART2 receiver
2026-07-14 Add cJSON parsing of STM32 telemetry into spindoctor_reading_t struct
2026-07-14 Add Gemini API integration: on-demand fault explanation via Apps Script trigger-poll loop, change-based Sheets logging, queue-decoupled UART/network tasks
2026-07-14 Add Session 16: ESP32 gateway, STM32-ESP32 UART link, Gemini integration, Apps Script backend
2026-07-15 Add live-status ring buffer and reuse HTTPS connection for Apps Script calls
    - Apps Script: new Live tab, update_live/get_live actions, 100-row
    ring buffer for dashboard live tile
    - Fix zero-value bug in update_live (0 was being written as blank)
    - ESP32: new live_update_task pushing latest classification every
    2.5s, independent of change-based historical logging
    - Reuse a persistent HTTPS client for all script.google.com calls
    instead of a fresh TLS handshake per call, cutting per-call latency
    - Fix missing cJSON_Parse(response) in gateway_poll_task (pre-existing
    bug, would not have compiled as written)
    [spindoctor_gateway.c]
2026-07-15 Refactor digital twin fan visualization and parameters
    Updated the digital twin fan representation and adjusted related parameters for rendering and interaction.
2026-07-16 Fix check_trigger silently failing to parse: split GET/POST HTTP clients
    - gateway_poll_task's check_trigger was never actually seeing
    trigger=true: the shared client's small default buffer_size caused
    intermittent 'Out of buffer' failures, and a since-reverted
    auto-redirect attempt caused the 302 page body and the final JSON to
    concatenate in the same buffer on every call, silently failing
    cJSON_Parse every time
    - Split into two persistent clients: one for POST (unchanged, bare 302
    = success, no redirect follow needed), one for GET (buffer_size
    raised to 8192, manual redirect retained but now with enough room
    and an explicit buffer clear between the two hops)
    - Confirmed wor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
    [spindoctor_gateway.c]
2026-07-16 Implement replay button and update online/offline visuals
    Added replay button functionality and visual updates for online/offline states.
2026-07-17 Add functionality overview for fan monitoring system
2026-07-17 Enhance README with badge images for fan states
    Updated the state table with badge images and improved descriptions.
2026-07-18 Add state-specific styles and replay button enhancements
2026-07-18 Add overview and architecture details for SpinDoctor
    Added an overview section detailing the SpinDoctor system, its architecture, and data flow, including a system diagram and rationale for using a fan for testing.
2026-07-18 Document hardware setup and components in TECHNICAL.md
    Added hardware components and physical setup details for the STM32F407G-DISC1 project, including fault state testing and wiring information.
2026-07-18 Enhance TECHNICAL.md with project groundwork details
    Added detailed documentation on groundwork and project structure for SpinDoctor, including STM32 and RTOS fundamentals, and structured bring-up sequence.
2026-07-18 Enhance TECHNICAL.md with firmware architecture details
    Expanded the technical documentation to include detailed firmware architecture, FreeRTOS task management, and design principles for STM32 integration.
2026-07-18 Enhance TECHNICAL.md with firmware architecture details
    Expanded the technical documentation to include detailed firmware architecture, task priorities, and semaphore usage for the STM32 FreeRTOS implementation.
2026-07-19 Add section on retiring FFT pipeline
    Documented the decision to retire the FFT pipeline after validating the sensor's performance.
2026-07-19 Document ESP32 Gateway project structure and tasks
    Added detailed documentation for the ESP32 Gateway project, including project structure, credential handling, WiFi setup, UART communication, HTTP client management, and task architecture.
2026-07-19 Enhance build/run instructions in TECHNICAL.md
    Added detailed build and run instructions for STM32 and ESP32 sides, including setup steps and configuration notes.
2026-07-19 Update TECHNICAL.md with detailed references
    Removed preliminary note about the technical writeup and added detailed references for FreeRTOS tasks, mutexes, semaphores, and ESP32 pin mapping.
